ifilot/BB48-FDC/pcb/bb48-fdc.kicad_pcb

## KiCad design pcb/bb48-fdc.kicad_pcb (2026-09-02)

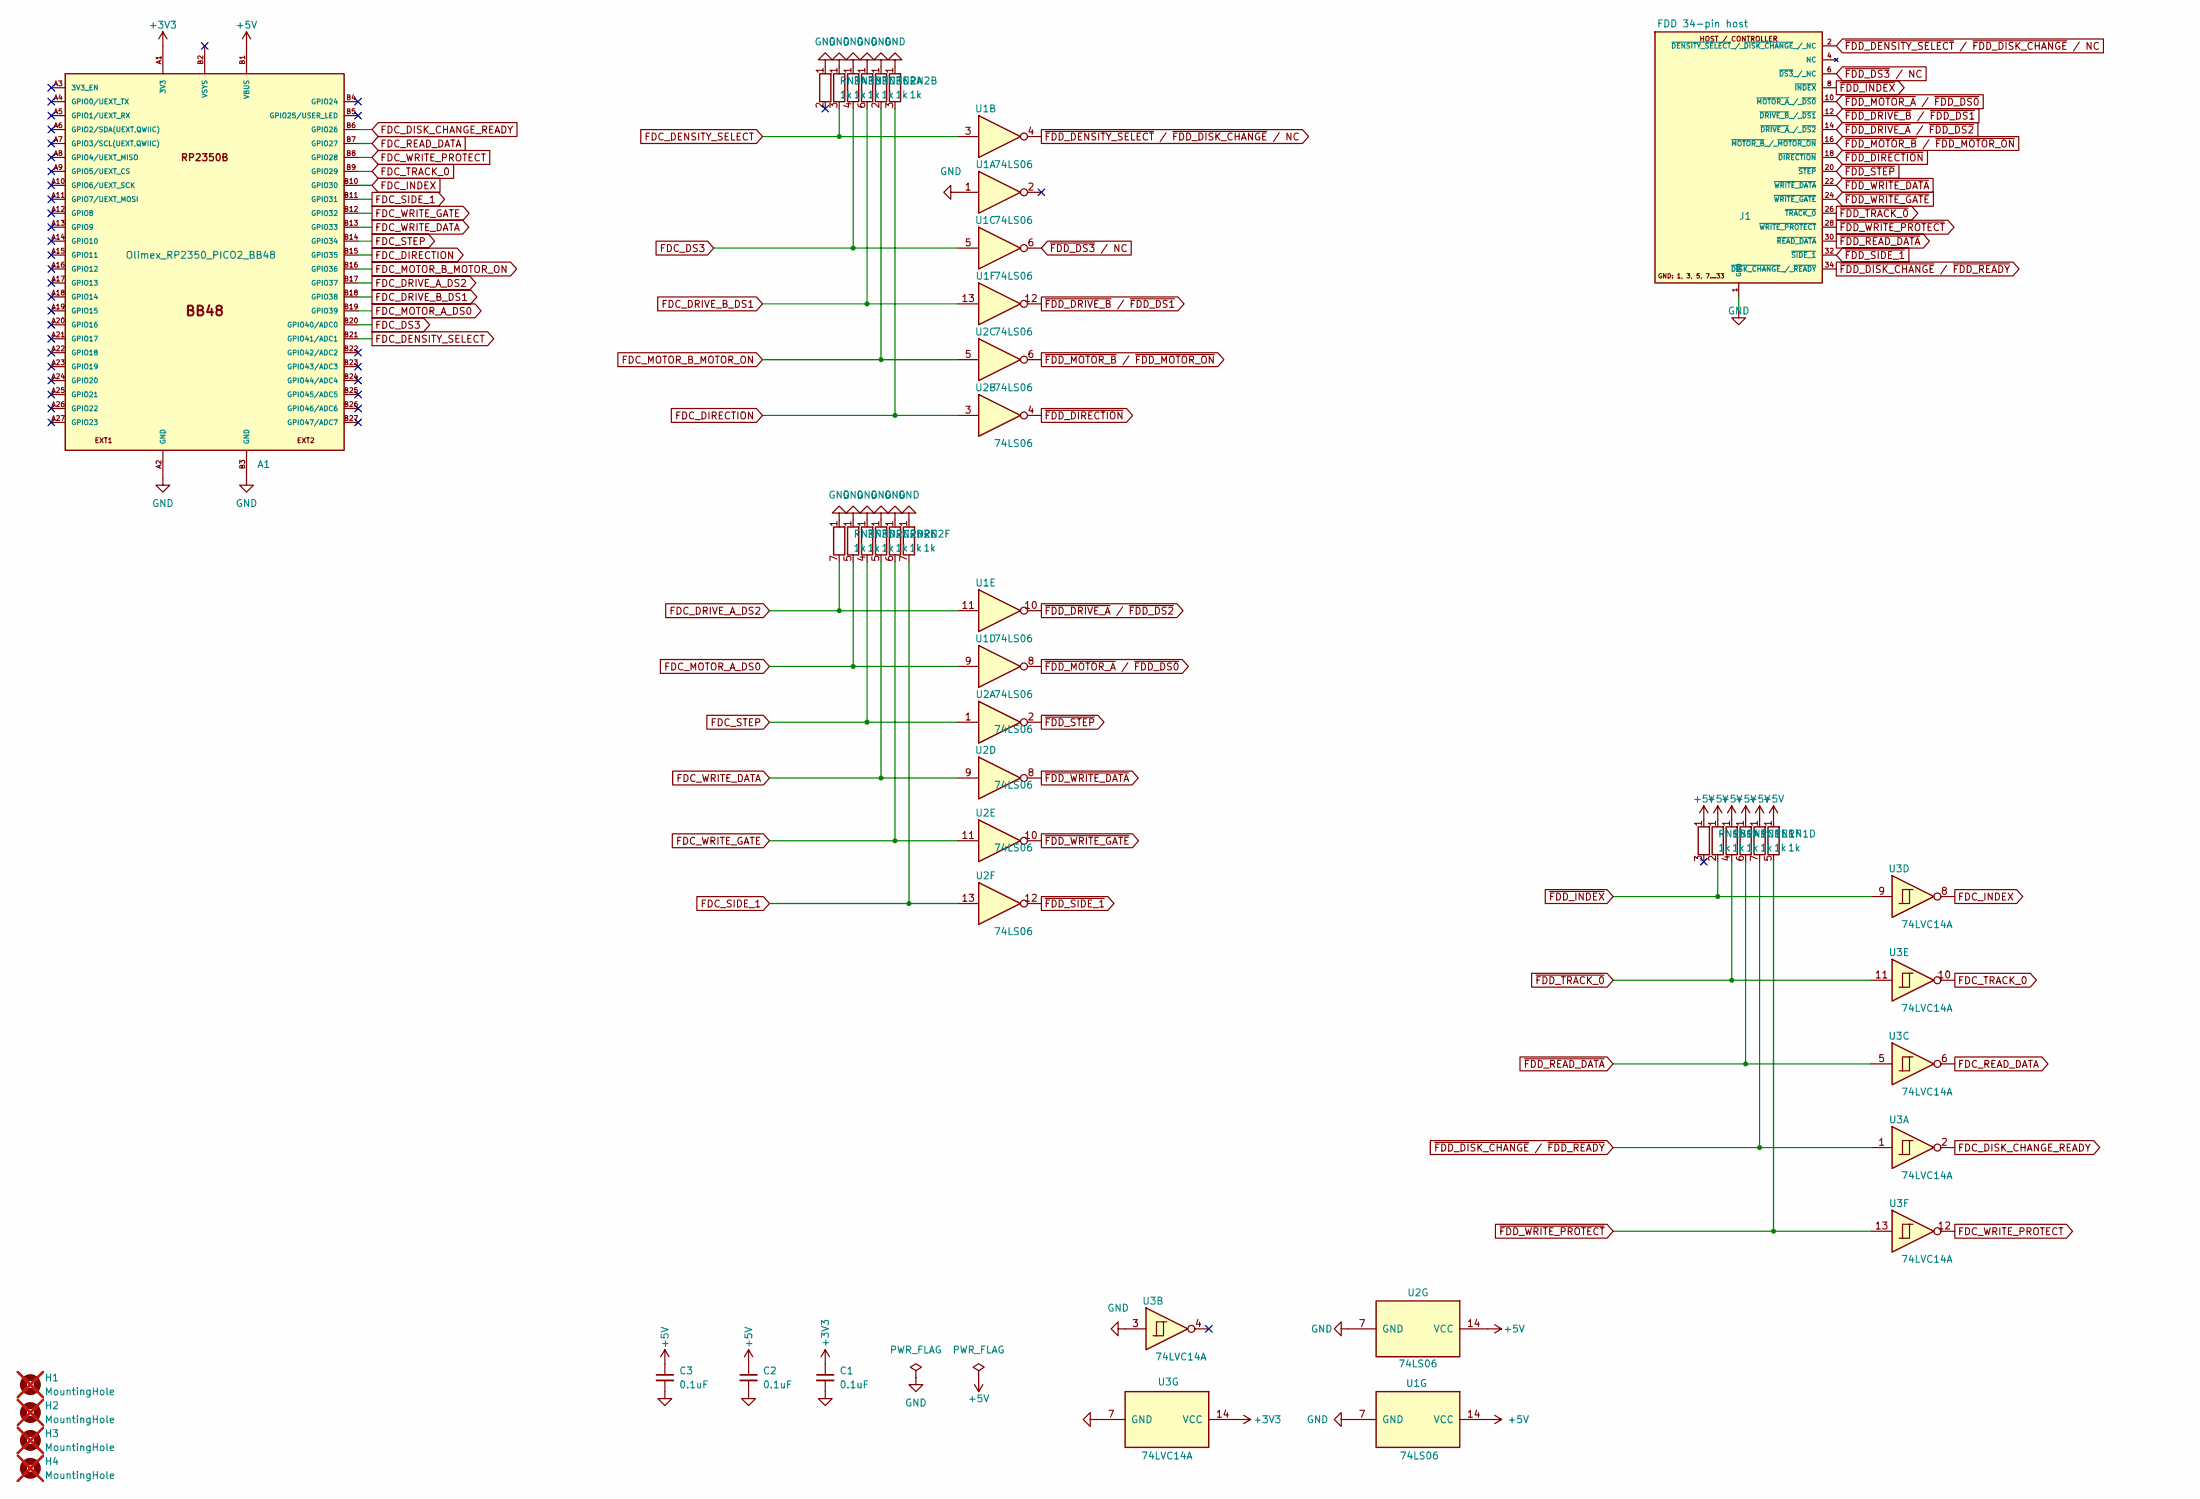
[picture p1: schematic bb48-fdc.kicad_sch]

Parts:
A1: Olimex_RP2350_PICO2_BB48
C1, C2, C3: 0.1uF; C_0805_2012Metric_Pad1.18x1.45mm_HandSolder
H1, H2, H3, H4: MountingHole; not fitted
J1: FDD 34-pin host; IDC-Header_2x17_P2.54mm_Vertical
RN1, RN2, RN3: 1k; R_Array_SIP7
U1, U2: 74LS06; SOIC-14_3.9x8.7mm_P1.27mm
U3: 74LVC14A; SOIC-14_3.9x8.7mm_P1.27mm

Connections:
+3V3: A1.A1 (3V3), C1.1, U3.14 (VCC)
+5V: A1.B1 (VBUS), C2.1, C3.1, RN1.1 (R1), U1.14 (VCC), U2.14 (VCC)
FDC_DENSITY_SELECT: A1.B21 (GPIO41/ADC1), RN3.3 (R2.2), U1.3
FDC_DIRECTION: A1.B15 (GPIO35), RN2.3 (R2.2), U2.3
FDC_DISK_CHANGE_READY: A1.B6 (GPIO26), U3.2
FDC_DRIVE_A_DS2: A1.B17 (GPIO37), RN3.7 (R6.2), U1.11
FDC_DRIVE_B_DS1: A1.B18 (GPIO38), RN3.6 (R5.2), U1.13
FDC_DS3: A1.B20 (GPIO40/ADC0), RN3.4 (R3.2), U1.5
FDC_INDEX: A1.B10 (GPIO30), U3.8
FDC_MOTOR_A_DS0: A1.B19 (GPIO39), RN3.5 (R4.2), U1.9
FDC_MOTOR_B_MOTOR_ON: A1.B16 (GPIO36), RN2.2 (R1.2), U2.5
FDC_READ_DATA: A1.B7 (GPIO27), U3.6
FDC_SIDE_1: A1.B11 (GPIO31), RN2.7 (R6.2), U2.13
FDC_STEP: A1.B14 (GPIO34), RN2.4 (R3.2), U2.1
FDC_TRACK_0: A1.B9 (GPIO29), U3.10
FDC_WRITE_DATA: A1.B13 (GPIO33), RN2.5 (R4.2), U2.9
FDC_WRITE_GATE: A1.B12 (GPIO32), RN2.6 (R5.2), U2.11
FDC_WRITE_PROTECT: A1.B8 (GPIO28), U3.12
GND: A1.A2 (GND), A1.B3 (GND), C1.2, C2.2, C3.2, J1.1 (GND), J1.3 (GND), J1.5 (GND), J1.7 (GND), J1.9 (GND), J1.11 (GND), J1.13 (GND), J1.15 (GND), J1.17 (GND), J1.19 (GND), J1.21 (GND), J1.23 (GND), J1.25 (GND), J1.27 (GND), J1.29 (GND), J1.31 (GND), J1.33 (GND), RN2.1 (R1), RN3.1 (R1), U1.1, U1.7 (GND), U2.7 (GND), U3.3, U3.7 (GND)
~FDD_DENSITY_SELECT / ~FDD_DISK_CHANGE / NC: J1.2 (~DENSITY_SELECT_/_~DISK_CHANGE_/_NC), U1.4
~FDD_DIRECTION: J1.18 (~DIRECTION), U2.4
~FDD_DISK_CHANGE / ~FDD_READY: J1.34 (~DISK_CHANGE_/_~READY), RN1.7 (R6.2), U3.1
~FDD_DRIVE_A / ~FDD_DS2: J1.14 (~DRIVE_A_/_~DS2), U1.10
~FDD_DRIVE_B / ~FDD_DS1: J1.12 (~DRIVE_B_/_~DS1), U1.12
~FDD_DS3 / NC: J1.6 (~DS3_/_NC), U1.6
~FDD_INDEX: J1.8 (~INDEX), RN1.2 (R1.2), U3.9
~FDD_MOTOR_A / ~FDD_DS0: J1.10 (~MOTOR_A_/_~DS0), U1.8
~FDD_MOTOR_B / ~FDD_MOTOR_ON: J1.16 (~MOTOR_B_/_~MOTOR_ON), U2.6
~FDD_READ_DATA: J1.30 (~READ_DATA), RN1.6 (R5.2), U3.5
~FDD_SIDE_1: J1.32 (~SIDE_1), U2.12
~FDD_STEP: J1.20 (~STEP), U2.2
~FDD_TRACK_0: J1.26 (~TRACK_0), RN1.4 (R3.2), U3.11
~FDD_WRITE_DATA: J1.22 (~WRITE_DATA), U2.8
~FDD_WRITE_GATE: J1.24 (~WRITE_GATE), U2.10
~FDD_WRITE_PROTECT: J1.28 (~WRITE_PROTECT), RN1.5 (R4.2), U3.13

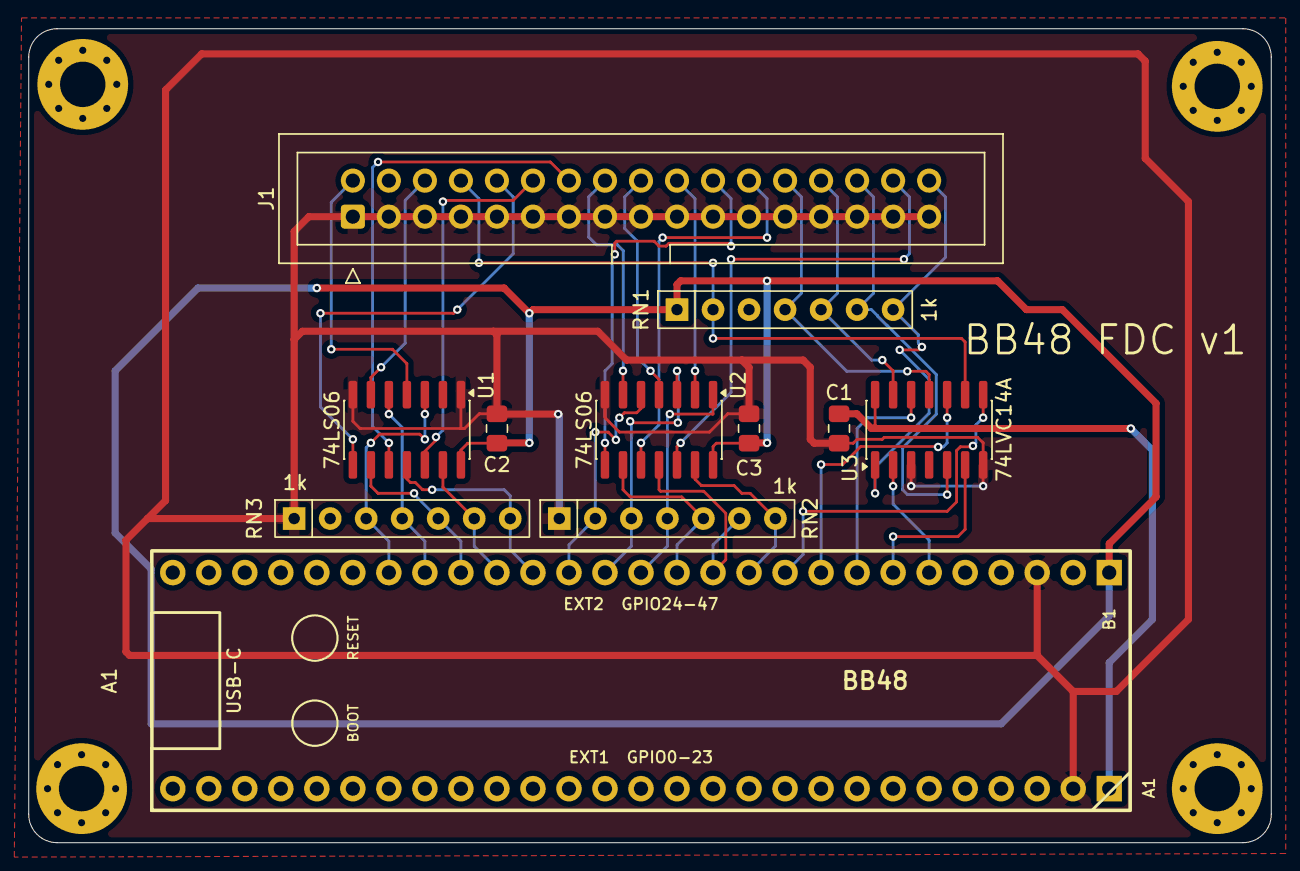
[picture p2: board bb48-fdc.kicad_pcb from above]

Board: 2 copper layers, 87.6 x 57.4 mm, 15 parts (0 on the bottom side), 35 nets.
