ifilot/BB48-FDC/(commit log)

2026-09-02 Revising design
    [bb48-fdc.kicad_pcb, bb48-fdc.kicad_sch]
2026-09-02 Cleaning up schematic
    [bb48-fdc.kicad_pcb, bb48-fdc.kicad_sch]
2026-09-02 Initial design PCB
    [bb48-fdc.kicad_pcb, bb48-fdc.kicad_sch]
